YodaTheCoder/DeathStarDisco/assorted-lengths-of-wire.jpg

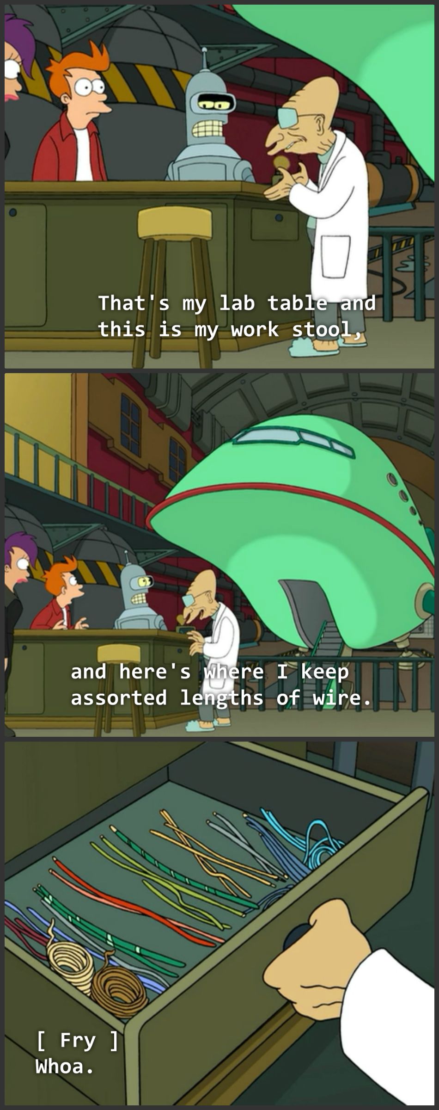
assorted-lengths-of-wire.jpg
